Major-Project-001/VIGIL-RQ/quadruped/scripts/stl_report.txt

====================================================================================================
STL MESH ANALYSIS ù All dimensions in mm (STL native units)
====================================================================================================

--- BODY ---
File                               SizeX   SizeY   SizeZ   CenterX  CenterY  CenterZ  Long
middle.stl                          45.7    20.0    80.1       0.1    109.4     68.2     Z
                                   min=(-22.8, 99.4, 28.2)  max=(22.9, 119.4, 108.3)
side_x2.stl                         55.9   234.1     5.9       0.1    109.4     27.9     Y
                                   min=(-27.8, -7.6, 25.0)  max=(28.0, 226.5, 30.9)
horizontal_x4.stl                    7.7   134.9    80.1     -24.2     41.9     69.7     Y
                                   min=(-28.0, -25.6, 29.7)  max=(-20.3, 109.4, 109.8)
legs_middle_x2.stl                  45.8    80.3    40.0       0.1    -55.7    133.6     Y
                                   min=(-22.8, -95.9, 113.5)  max=(23.0, -15.6, 153.6)

--- HIP ---
File                               SizeX   SizeY   SizeZ   CenterX  CenterY  CenterZ  Long
hip_1.stl                           45.8    70.7    90.1       0.2    -60.0     54.4     Z
                                   min=(-22.8, -95.4, 9.3)  max=(23.1, -24.7, 99.4)
hip_2.stl                           45.8    22.0    77.2       0.2    -13.4     60.7     Z
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
                                   min=(38.1, 20.7, 34.8)  max=(62.0, 35.7, 101.8)
realsense_adapter.stl               19.2    79.5    26.0       6.2     -0.0      2.6     Y
                                   min=(-3.4, -39.8, -10.4)  max=(15.8, 39.7, 15.6)
