Major-Project-001/VIGIL-RQ/context.md

Here’s your entire content converted into a clean **Markdown (.md) file format** — structured, readable, and ready to drop into your repo or documentation.

---

```md
# 🧠 Vision Module Prompt + Project Structure (Quadruped Robotics)

---

## 🔥 ANTIGRAVITY PROMPT

You are building a modular Python-based vision system for a quadruped robotics project.

The goal is to implement the **Vision and Perception Layer** of a larger robotics pipeline, where webcam input is processed using MediaPipe to extract human pose or hand landmarks, and convert them into high-level directional commands (LEFT, RIGHT, FORWARD, STOP).

This module must be clean, modular, and extensible so it can later integrate with:
- Reinforcement Learning locomotion (PPO)
- FPGA-based motor control
- Real-time robot navigation

---

### 📌 FUNCTIONAL REQUIREMENTS

1. Capture real-time video from webcam using OpenCV  
2. Use MediaPipe for:
   - Pose detection (primary)
   - Hand detection (optional module)  
3. Extract landmark coordinates (normalized x, y)  
4. Convert landmarks into decisions:
   - Nose.x < 0.4 → MOVE LEFT  
   - Nose.x > 0.6 → MOVE RIGHT  
   - Otherwise → CENTER / FORWARD  
5. Display:
   - Annotated video feed (with landmarks)
   - Current decision text overlay  
6. Print decisions to console (for debugging)

---

### 📌 SYSTEM DESIGN REQUIREMENTS

- Follow modular architecture  
- Separate concerns:
  - Vision processing  
  - Decision logic  
  - Application entry point  
- Code must be readable, commented, and beginner-friendly  
- Avoid unnecessary complexity  

---

### 📌 FILE STRUCTURE TO IMPLEMENT

```

project_root/
│
├── main.py                  # Entry point
│
├── vision/
│   ├── **init**.py
│   ├── pose_detector.py     # MediaPipe pose logic
│   ├── hand_detector.py     # (optional) hand tracking
│
├── logic/
│   ├── **init**.py
│   ├── decision.py          # Converts coordinates → commands
│
├── utils/
│   ├── **init**.py
│   ├── display.py           # Drawing + UI overlays
│
├── config/
│   ├── settings.py          # Thresholds (0.4, 0.6 etc.)
│
└── requirements.txt

````

---

### 📌 IMPLEMENTATION DETAILS

#### `pose_detector.py`
- Initialize MediaPipe Pose  
- Process frame → return landmarks  
- Provide helper function:
```python
get_keypoint(landmarks, index)
````

#### `decision.py`

* Function:

```python
get_direction(nose_x)
```

* Returns:

```
"LEFT", "RIGHT", "CENTER"
```

#### `display.py`

* Draw landmarks
* Overlay direction text
* Show output window

#### `main.py`

* Capture webcam
* Call pose detector
* Extract nose coordinate
* Pass to decision logic
* Display results

---

### 📌 OUTPUT EXPECTATIONS

* Working real-time webcam system
* Clean console logs
* Visual feedback window
* Easily extendable for:

  * YOLO integration
  * Robot control commands

---

### 📌 CONTEXT (IMPORTANT)

This is part of a quadruped robotics system where:

* Vision runs on a laptop
* Control runs on FPGA
* Decisions from this module will later drive locomotion

Keep code lightweight and CPU-efficient.

---

## 📁 PROJECT STRUCTURE

```
quadruped_vision/
│
├── main.py
│
├── vision/
│   ├── pose_detector.py
│   ├── hand_detector.py
│
├── logic/
│   ├── decision.py
│
├── utils/
│   ├── display.py
│
├── config/
│   ├── settings.py
│
└── requirements.txt
```

---

## 🧠 WHY THIS STRUCTURE

### 🔹 vision/

Handles **perception layer**

* MediaPipe now
* YOLO later

---

### 🔹 logic/

Handles **decision making**

* Converts raw data → commands
* Later becomes:

  * RL input
  * Navigation logic

---

### 🔹 utils/

Handles **UI/debug**

* Keeps core logic clean
* Prevents messy code

---

### 🔹 config/

Critical for tuning:

```python
LEFT_THRESHOLD = 0.4
RIGHT_THRESHOLD = 0.6
```

---

### 🔹 main.py

Pipeline controller:

```
Camera → Vision → Logic → Output
```

---

## ⚠️ IMPORTANT NOTE

Avoid putting everything in one file.

If you do:

* YOLO integration becomes painful
* FPGA integration becomes messy
* Debugging becomes harder

This structure = scalable + maintainable

---

## 🚀 HOW TO RUN

```bash
python main.py
```

---

## ✅ EXPECTED RESULT

* Webcam opens
* Pose landmarks visible
* LEFT / RIGHT / CENTER printed
* Overlay visible on screen

---

## 🔜 NEXT PHASE

After this works:

* Replace MediaPipe with YOLO (or hybrid)
* Send output → FPGA (via Serial / Socket)
* Integrate with RL locomotion

---

## 🧩 SYSTEM FLOW

```
Camera → Vision → Decision → FPGA → Robot Movement
```

---

## 🧠 FINAL NOTE

This module is not just a demo.

It becomes:

* Your perception system
* Your control trigger
* Your integration bridge

Treat it like a real subsystem, not a script.

```

---

If you want, I can also:
- Generate a **downloadable `.md` file**
- Or convert this into a **GitHub-ready README with badges + diagrams**
```
