Major-Project-001/VIGIL-RQ/image.png

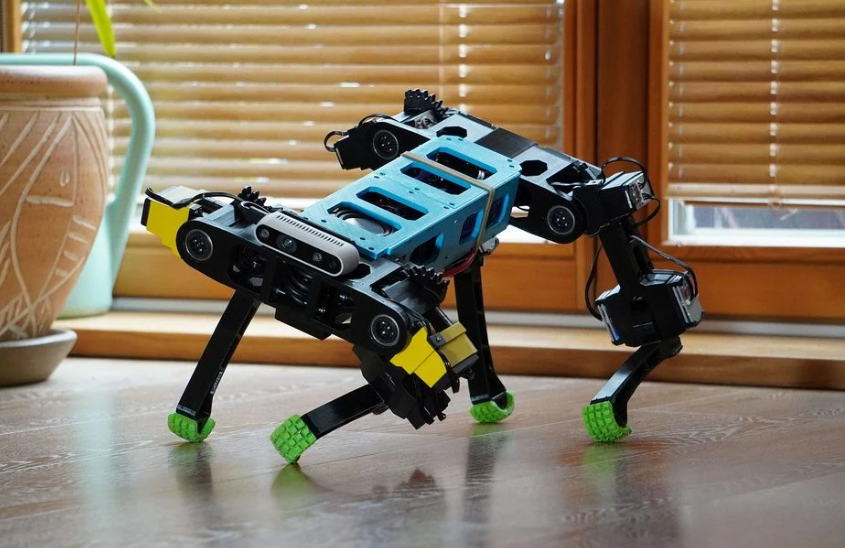
image.png
