Major-Project-001/VIGIL-RQ/quadruped/urdf/meshes/middle.stl

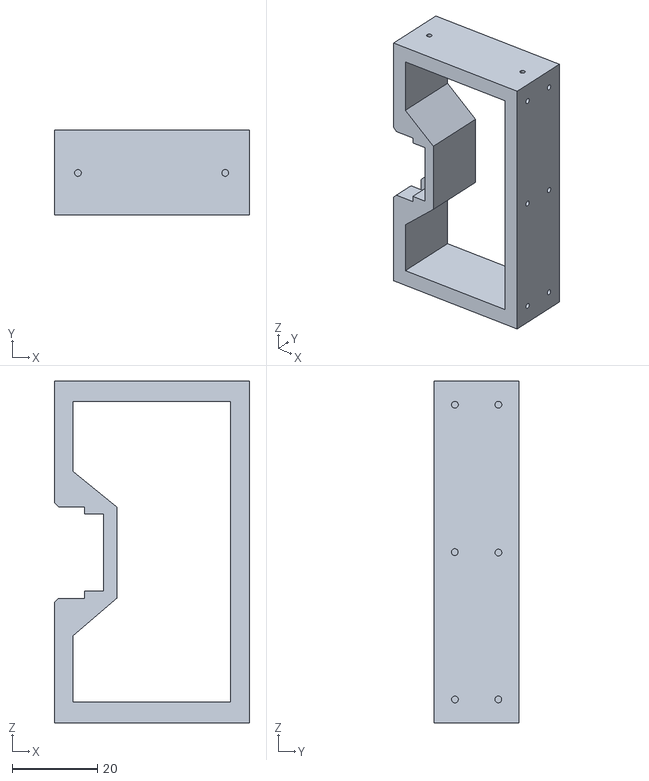
[picture p9: CAD file, 2026-04-13]
quadruped/urdf/meshes/middle.stl
45.7 x 20.0 x 80.1
