Major-Project-001/VIGIL-RQ/quadruped/urdf/meshes_centered/PI4_up.stl

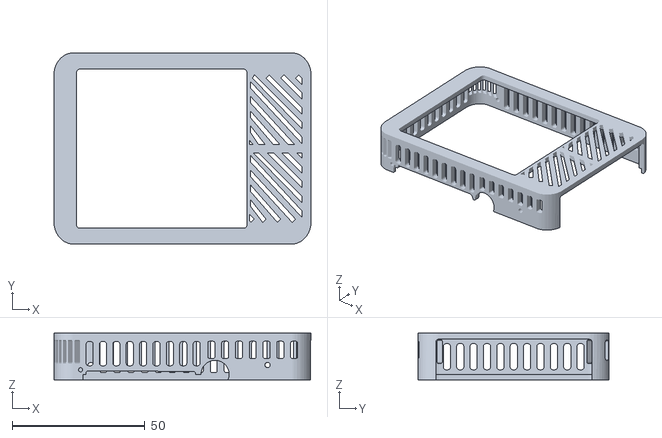
[picture p10: CAD file, 2026-04-13]
quadruped/urdf/meshes_centered/PI4_up.stl
96.9 x 72.2 x 17.7
