Major-Project-001/VIGIL-RQ/quadruped/urdf/meshes_export/29KG_Servo_DS3218MG_001.stl

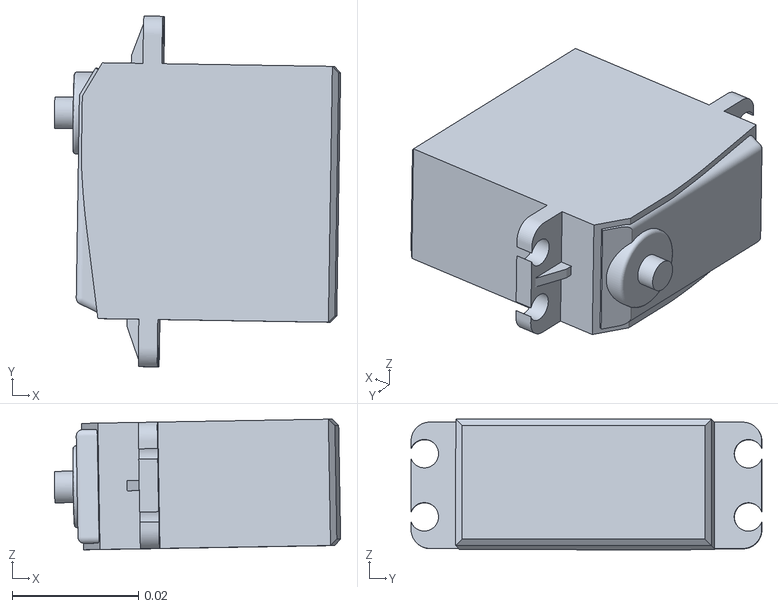
[picture p11: CAD file, 2026-04-13]
quadruped/urdf/meshes_export/29KG_Servo_DS3218MG_001.stl
0.0453 x 0.0555 x 0.0207
