Major-Project-001/VIGIL-RQ/quadruped/urdf/meshes/hip_servo_gear.stl

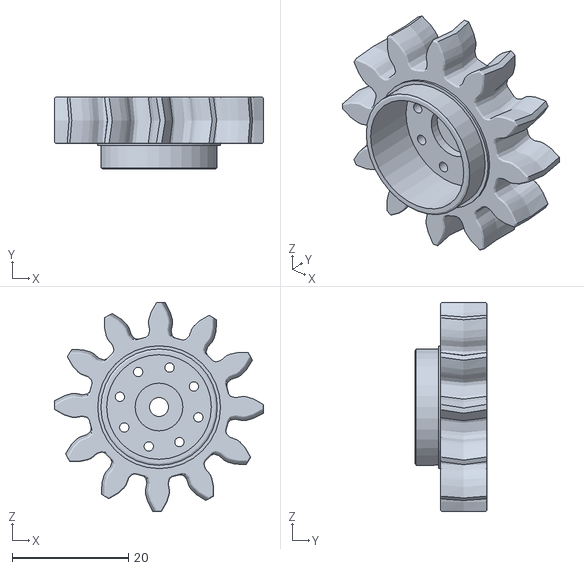
[picture p12: CAD file, 2026-04-13]
quadruped/urdf/meshes/hip_servo_gear.stl
36.0 x 12.4 x 36.0
