Major-Project-001/VIGIL-RQ/quadruped/urdf/meshes_centered/PI4_down.stl

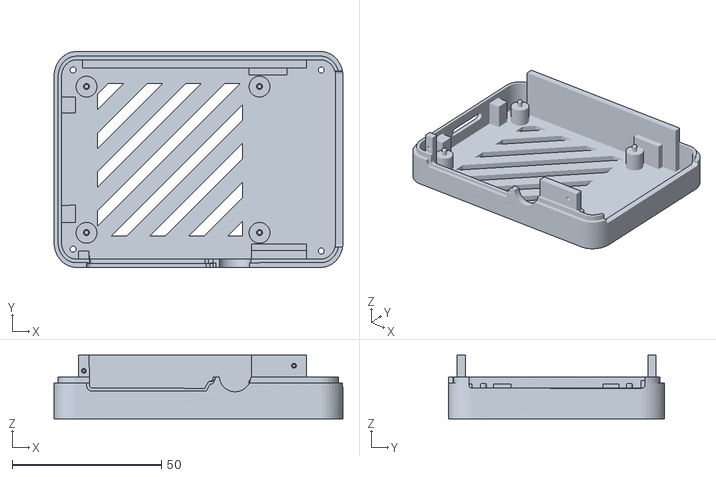
[picture p13: CAD file, 2026-04-13]
quadruped/urdf/meshes_centered/PI4_down.stl
96.9 x 72.4 x 21.4
