Major-Project-001/VIGIL-RQ/quadruped/urdf/meshes_export/RR__lower_leg_servo_horn_x2_005.stl

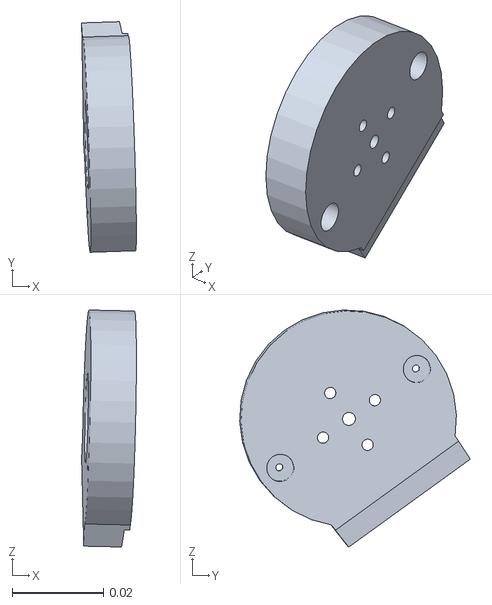
[picture p14: CAD file, 2026-04-13]
quadruped/urdf/meshes_export/RR__lower_leg_servo_horn_x2_005.stl
0.012 x 0.0505 x 0.0519
