Major-Project-001/VIGIL-RQ/quadruped/urdf/meshes/foot.stl

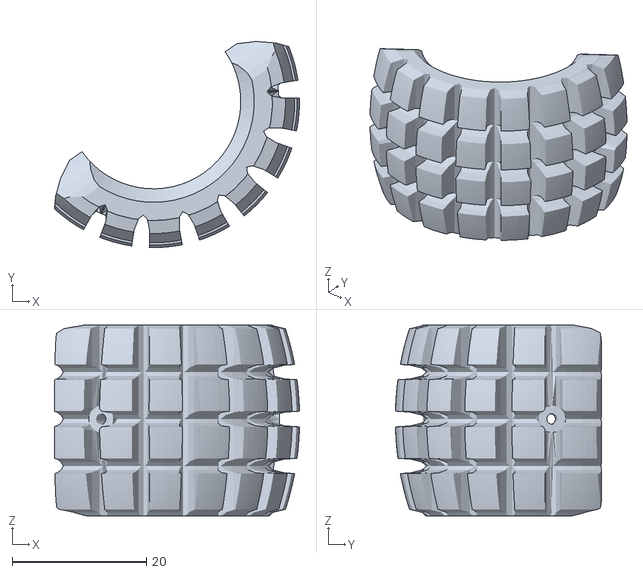
[picture p15: CAD file, 2026-04-13]
quadruped/urdf/meshes/foot.stl
36.5 x 30.7 x 28.4
