Major-Project-001/VIGIL-RQ/quadruped/urdf/meshes_export/29KG_Servo_DS3218MG.stl

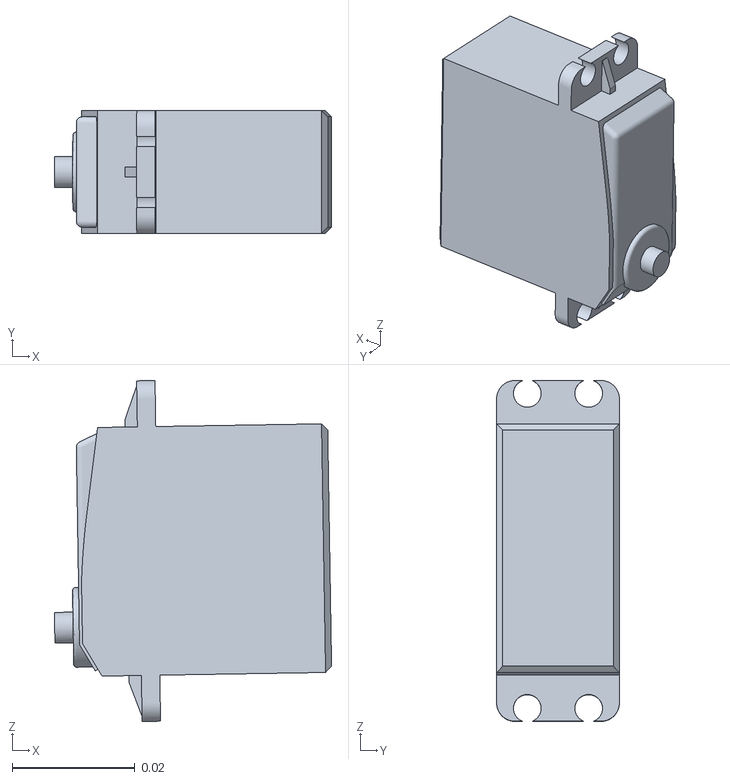
[picture p16: CAD file, 2026-04-13]
quadruped/urdf/meshes_export/29KG_Servo_DS3218MG.stl
0.0451 x 0.02 x 0.0555
