Major-Project-001/VIGIL-RQ/quadruped/urdf/meshes/lower_leg.stl

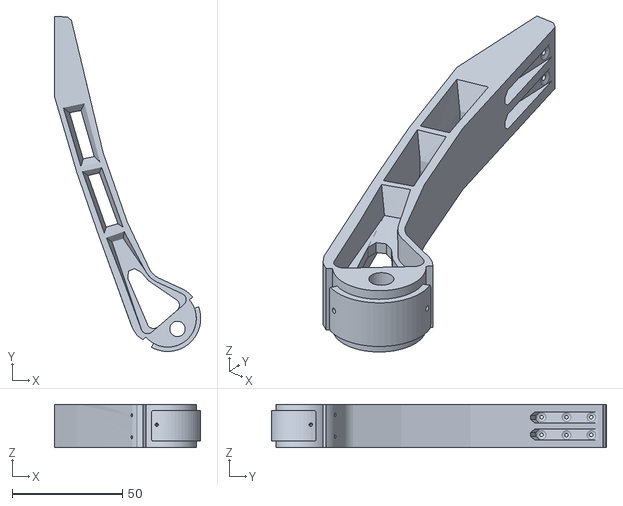
[picture p17: CAD file, 2026-04-13]
quadruped/urdf/meshes/lower_leg.stl
66.5 x 152.1 x 19.7
