Major-Project-001/VIGIL-RQ/quadruped/urdf/meshes_centered/side_x2.stl

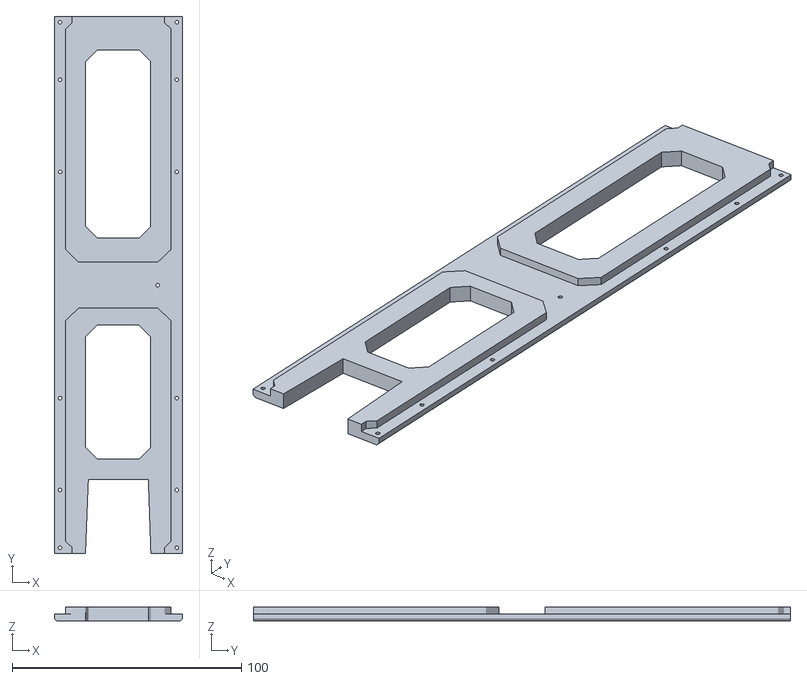
[picture p18: CAD file, 2026-04-13]
quadruped/urdf/meshes_centered/side_x2.stl
55.9 x 234.1 x 5.91
