Major-Project-001/VIGIL-RQ/quadruped/urdf/meshes_export/legs_middle_x2_001.stl

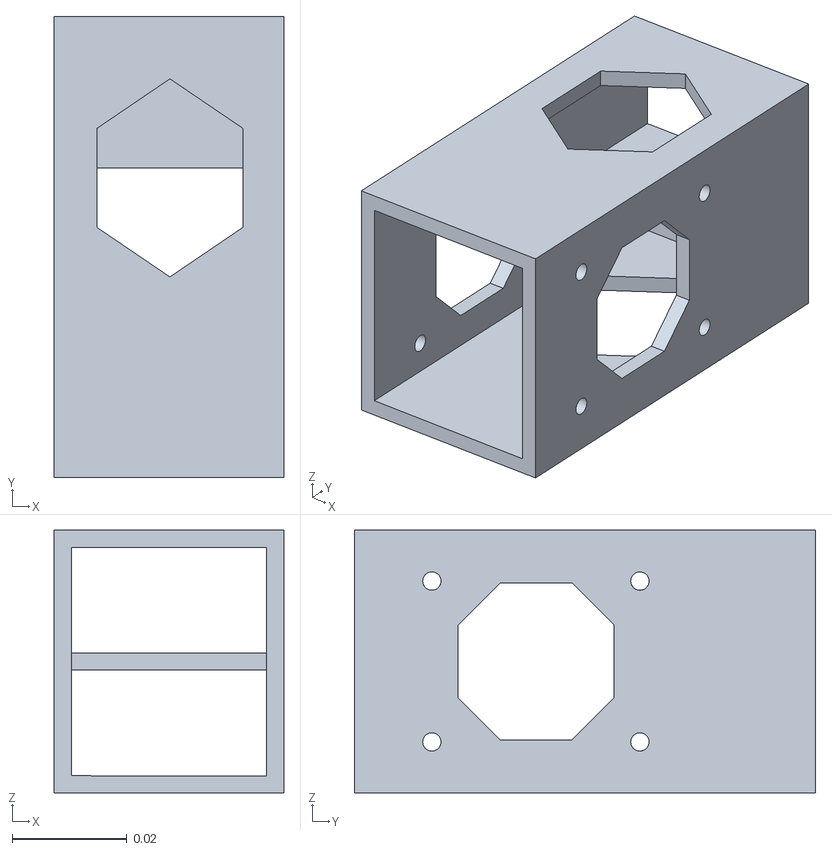
[picture p19: CAD file, 2026-04-13]
quadruped/urdf/meshes_export/legs_middle_x2_001.stl
0.04 x 0.0803 x 0.0458
