Major-Project-001/VIGIL-RQ/quadruped/urdf/meshes_centered/legs_middle_x2.stl

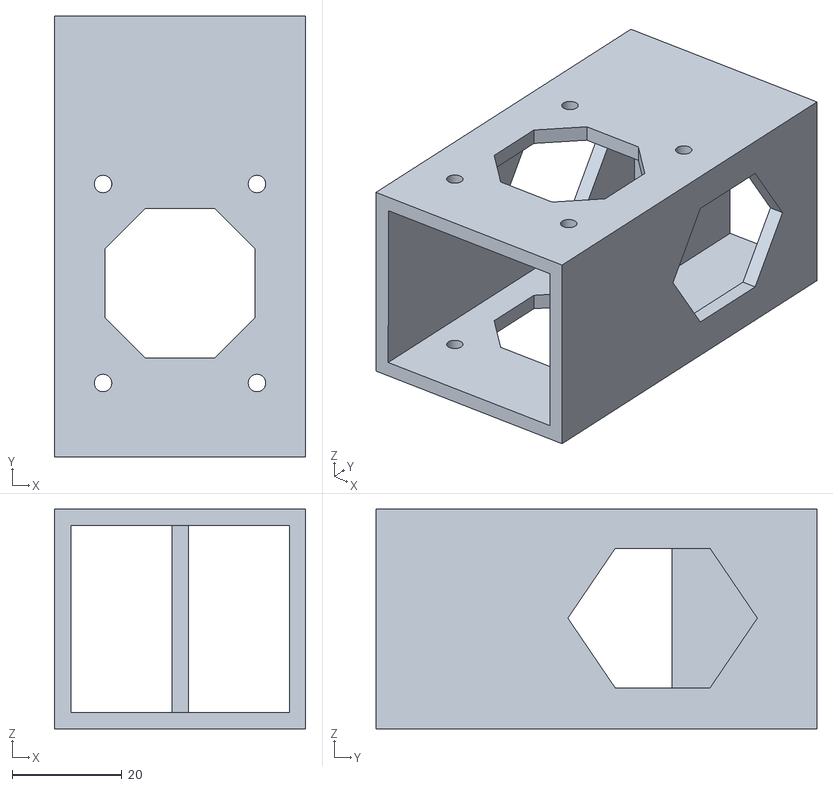
[picture p20: CAD file, 2026-04-13]
quadruped/urdf/meshes_centered/legs_middle_x2.stl
45.8 x 80.3 x 40.0
