Major-Project-001/VIGIL-RQ/quadruped/urdf/meshes_export/horizontal_x4_002.stl

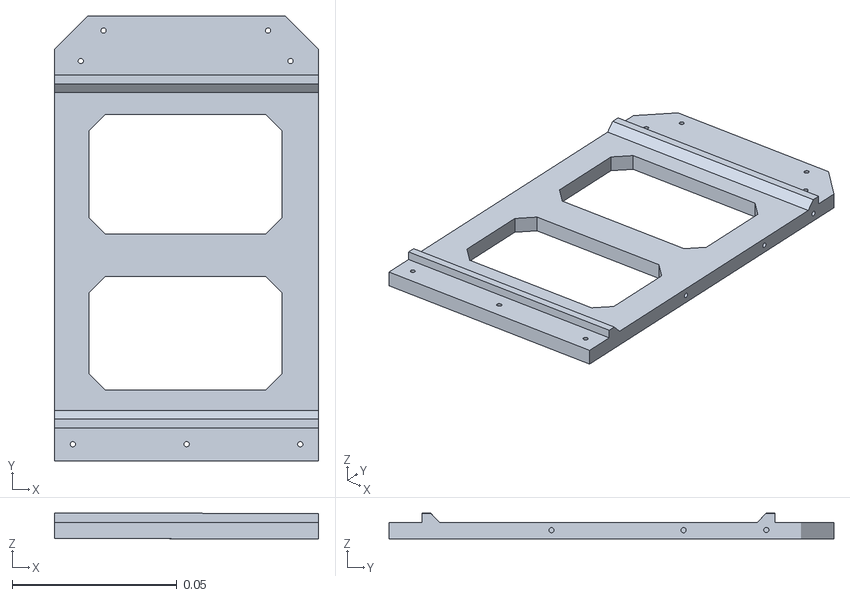
[picture p21: CAD file, 2026-04-13]
quadruped/urdf/meshes_export/horizontal_x4_002.stl
0.0801 x 0.135 x 0.00775
