Major-Project-001/VIGIL-RQ/quadruped/urdf/meshes_local/RR__lower_leg_001.stl

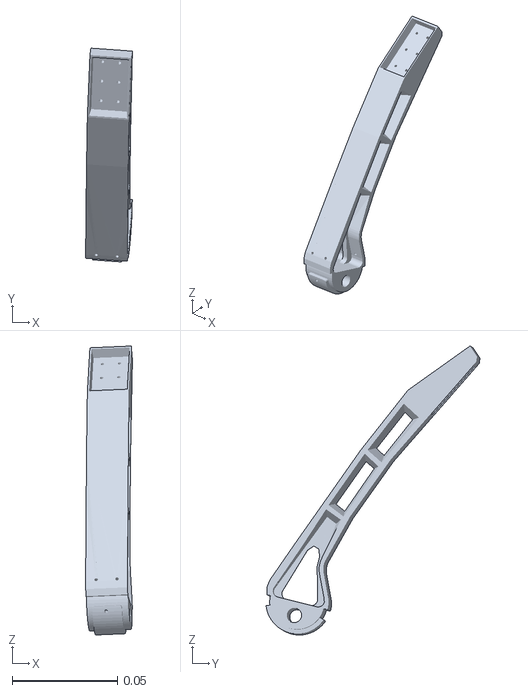
[picture p22: CAD file, 2026-04-13]
quadruped/urdf/meshes_local/RR__lower_leg_001.stl
0.0222 x 0.101 x 0.137
