Major-Project-001/VIGIL-RQ/quadruped/urdf/meshes/hip_cup.stl

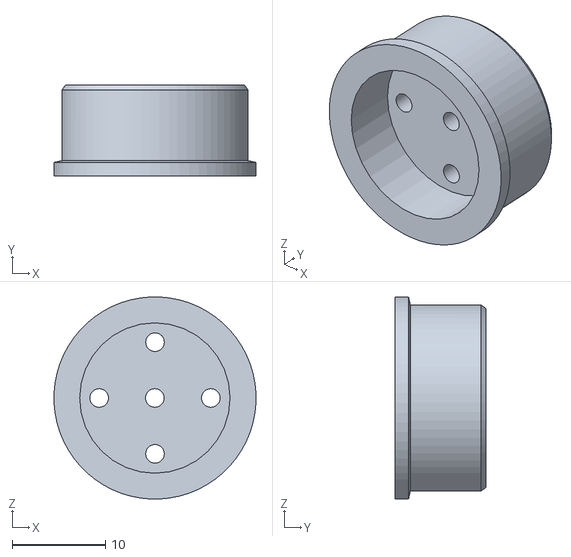
[picture p23: CAD file, 2026-04-13]
quadruped/urdf/meshes/hip_cup.stl
21.7 x 9.74 x 21.7
