Major-Project-001/VIGIL-RQ/quadruped/urdf/meshes_centered/realsense_adapter.stl

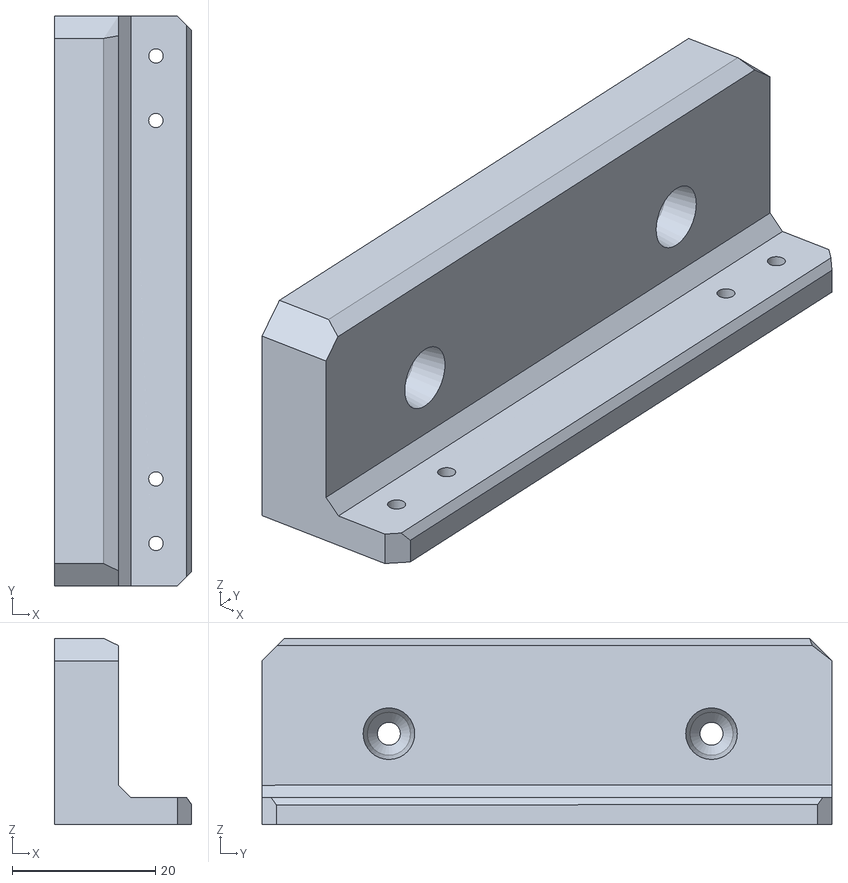
[picture p24: CAD file, 2026-04-13]
quadruped/urdf/meshes_centered/realsense_adapter.stl
19.2 x 79.5 x 26.0
