Major-Project-001/VIGIL-RQ/quadruped/urdf/meshes_local/RR__upper_leg_x2_003.stl

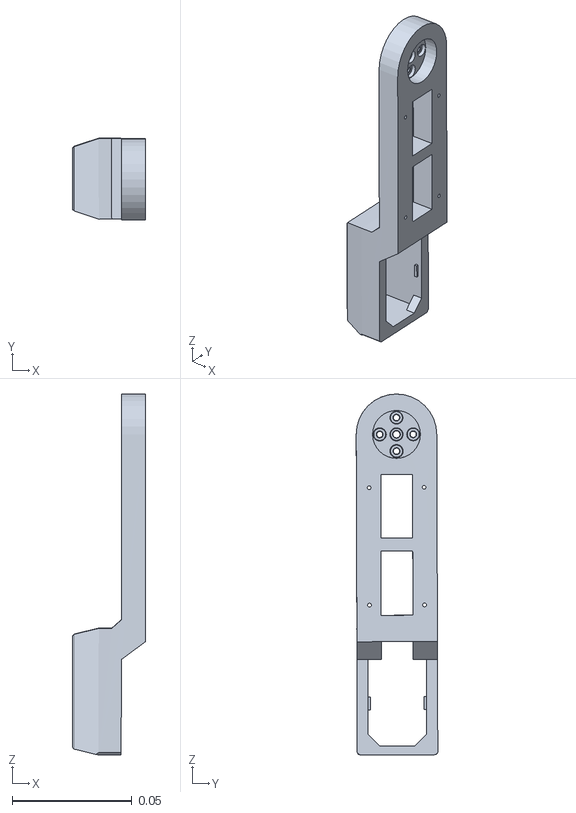
[picture p25: CAD file, 2026-04-13]
quadruped/urdf/meshes_local/RR__upper_leg_x2_003.stl
0.0306 x 0.0341 x 0.151
