Major-Project-001/VIGIL-RQ/quadruped/urdf/meshes/battery_support_2.stl

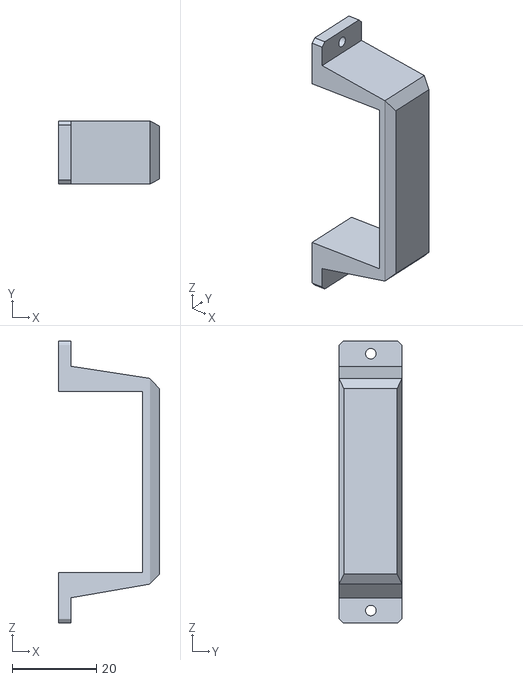
[picture p26: CAD file, 2026-04-13]
quadruped/urdf/meshes/battery_support_2.stl
24.0 x 15.0 x 67.0
