Major-Project-001/VIGIL-RQ/quadruped/urdf/meshes_centered/hip_1.stl

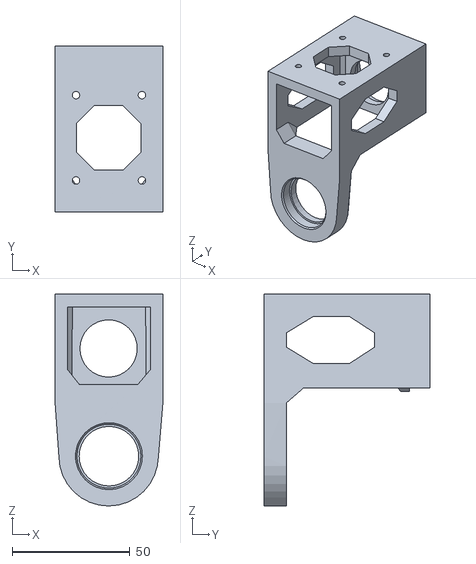
[picture p27: CAD file, 2026-04-13]
quadruped/urdf/meshes_centered/hip_1.stl
45.8 x 70.7 x 90.1
