Major-Project-001/VIGIL-RQ/quadruped/urdf/meshes/lower_leg_servo_horn_x2.stl

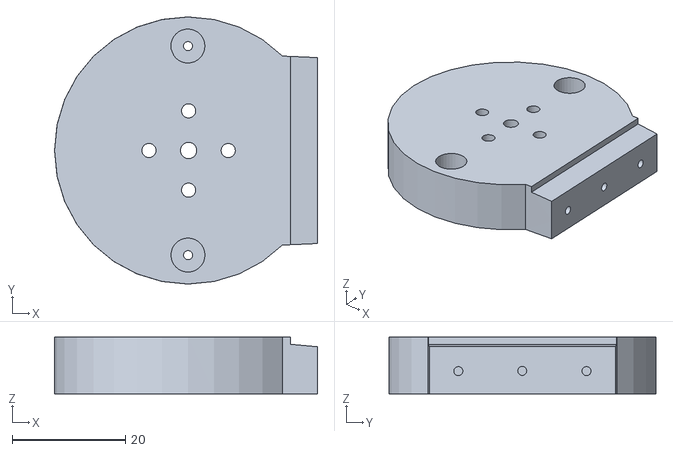
[picture p28: CAD file, 2026-04-13]
quadruped/urdf/meshes/lower_leg_servo_horn_x2.stl
46.5 x 47.2 x 9.98
