Major-Project-001/VIGIL-RQ/quadruped/urdf/meshes_centered/servo_frame_1.stl

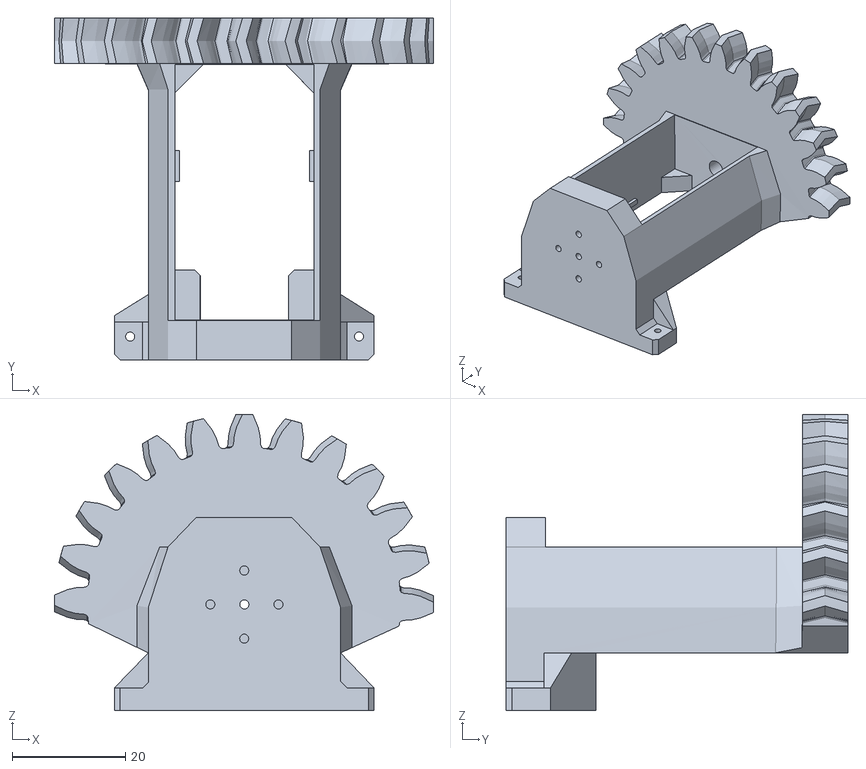
[picture p29: CAD file, 2026-04-13]
quadruped/urdf/meshes_centered/servo_frame_1.stl
66.8 x 60.2 x 52.3
