Major-Project-001/VIGIL-RQ/quadruped/urdf/meshes_local/RR__foot_002.stl

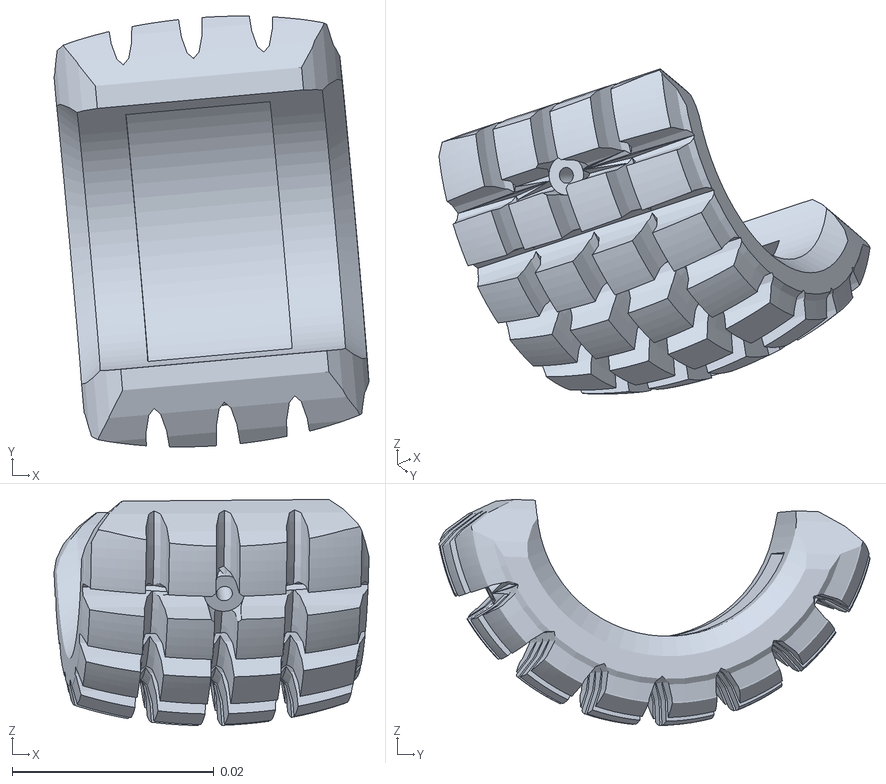
[picture p30: CAD file, 2026-04-13]
quadruped/urdf/meshes_local/RR__foot_002.stl
0.0312 x 0.0427 x 0.0224
