Major-Project-001/VIGIL-RQ/quadruped/urdf/meshes_centered/ESC_down.stl

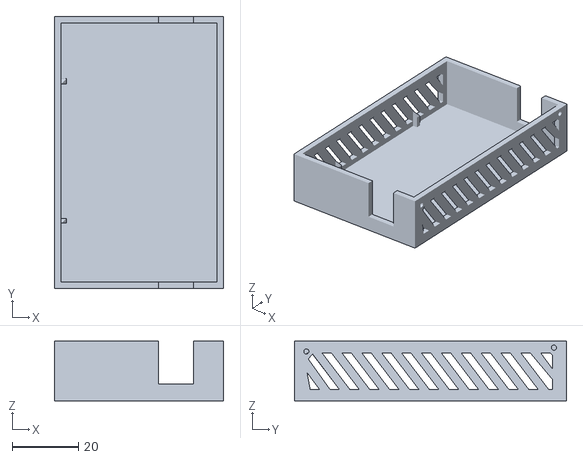
[picture p31: CAD file, 2026-04-13]
quadruped/urdf/meshes_centered/ESC_down.stl
51.1 x 82.1 x 18.0
