Major-Project-001/VIGIL-RQ/quadruped/urdf/meshes_local/RR__servo_frame_1_002.stl

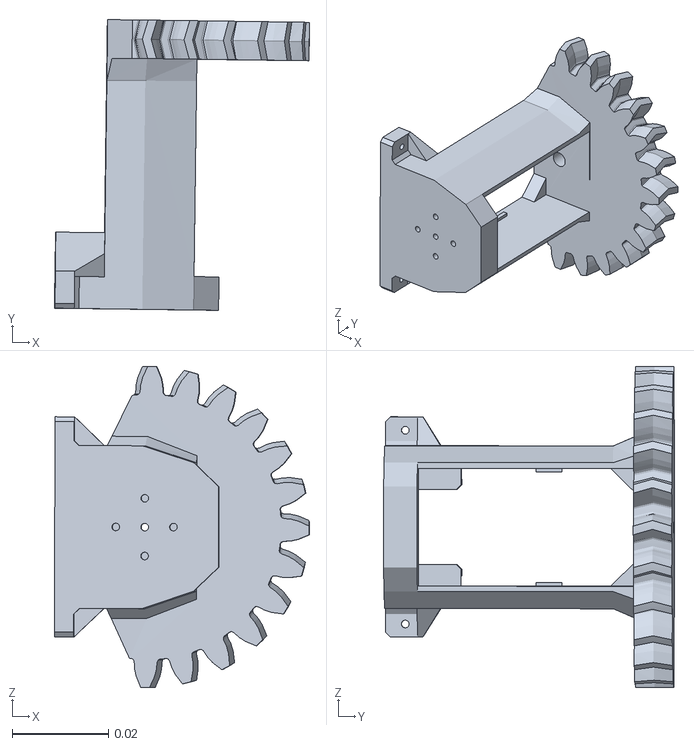
[picture p32: CAD file, 2026-04-13]
quadruped/urdf/meshes_local/RR__servo_frame_1_002.stl
0.0531 x 0.0605 x 0.0668
