Major-Project-001/VIGIL-RQ/quadruped/urdf/meshes/upper_leg_x2.stl

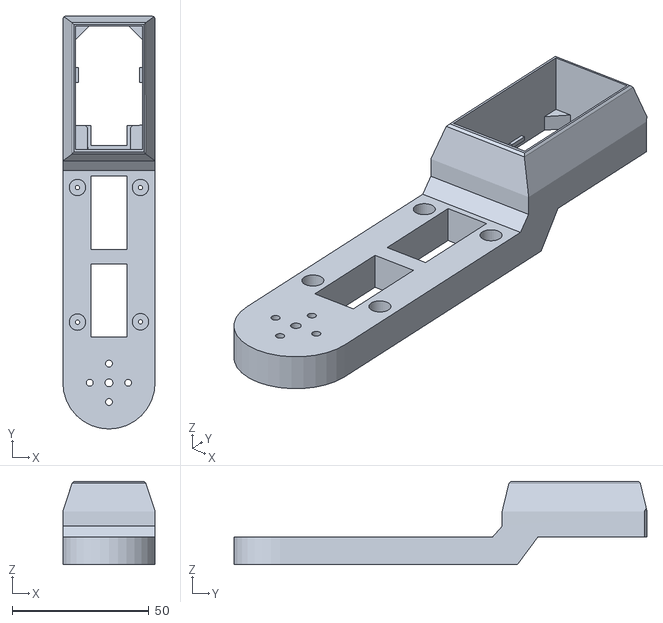
[picture p33: CAD file, 2026-04-13]
quadruped/urdf/meshes/upper_leg_x2.stl
33.7 x 150.8 x 30.4
