Major-Project-001/VIGIL-RQ/quadruped/urdf/meshes_centered/hip_2.stl

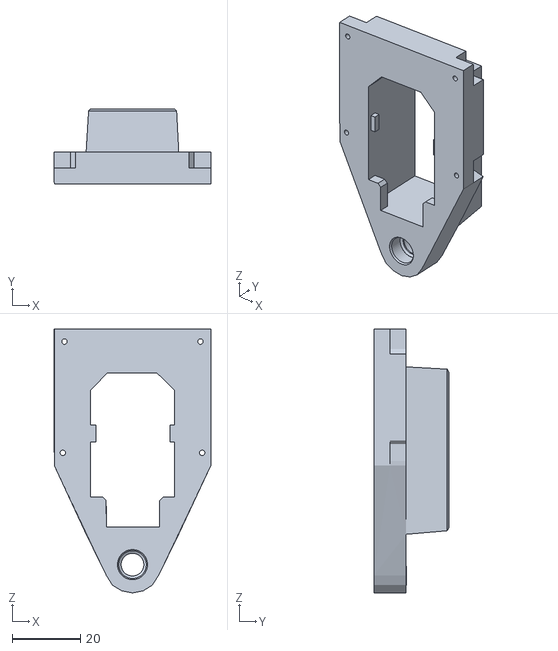
[picture p34: CAD file, 2026-04-13]
quadruped/urdf/meshes_centered/hip_2.stl
45.8 x 22.0 x 77.2
