Major-Project-001/VIGIL-RQ/quadruped/urdf/meshes_local/hip_servo_gear_001.stl

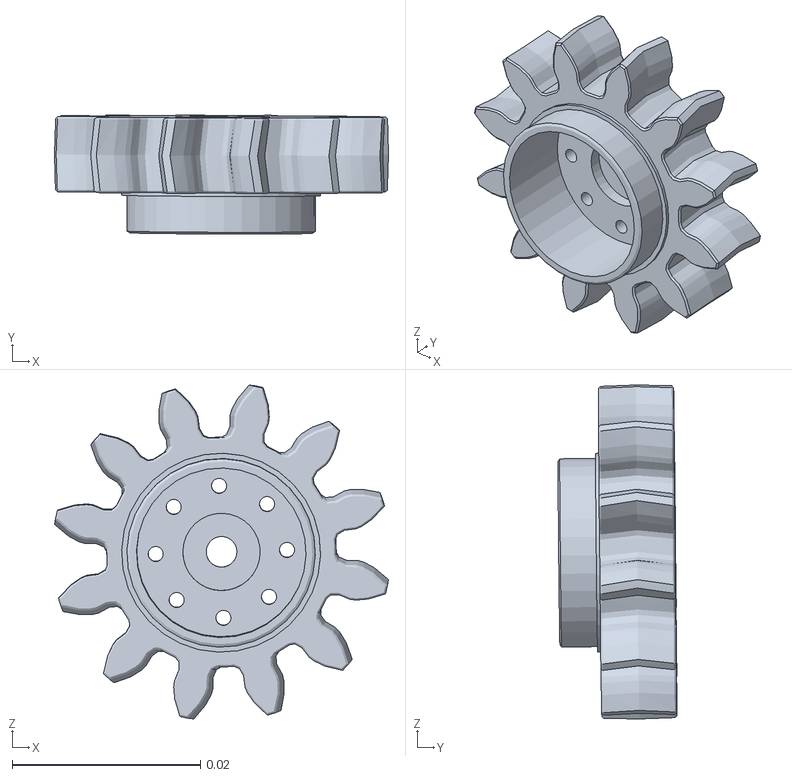
[picture p35: CAD file, 2026-04-13]
quadruped/urdf/meshes_local/hip_servo_gear_001.stl
0.0355 x 0.0127 x 0.0355
