Major-Project-001/VIGIL-RQ/quadruped/urdf/meshes_export/RR__hip_2_001.stl

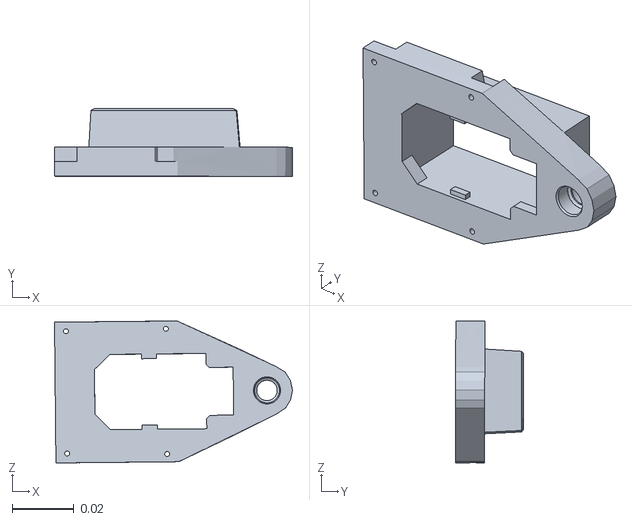
[picture p36: CAD file, 2026-04-13]
quadruped/urdf/meshes_export/RR__hip_2_001.stl
0.0774 x 0.0221 x 0.0462
