Major-Project-001/VIGIL-RQ/quadruped/urdf/meshes_local/hip_1.stl

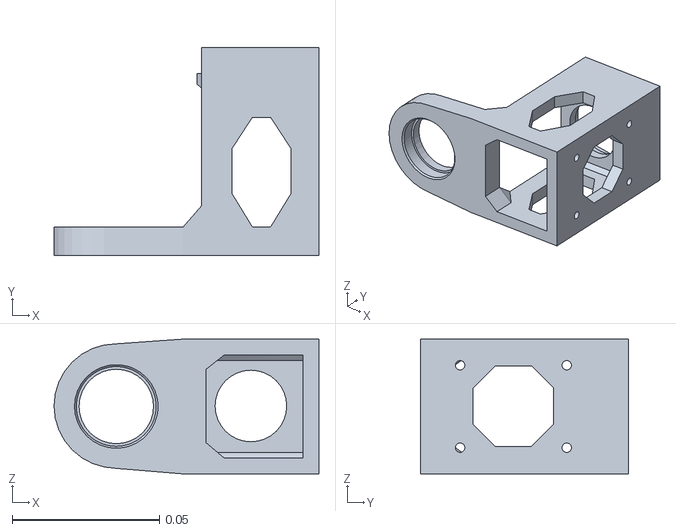
[picture p37: CAD file, 2026-04-13]
quadruped/urdf/meshes_local/hip_1.stl
0.0901 x 0.0707 x 0.0458
