Major-Project-001/VIGIL-RQ/quadruped/urdf/meshes/servo_frame_2.stl

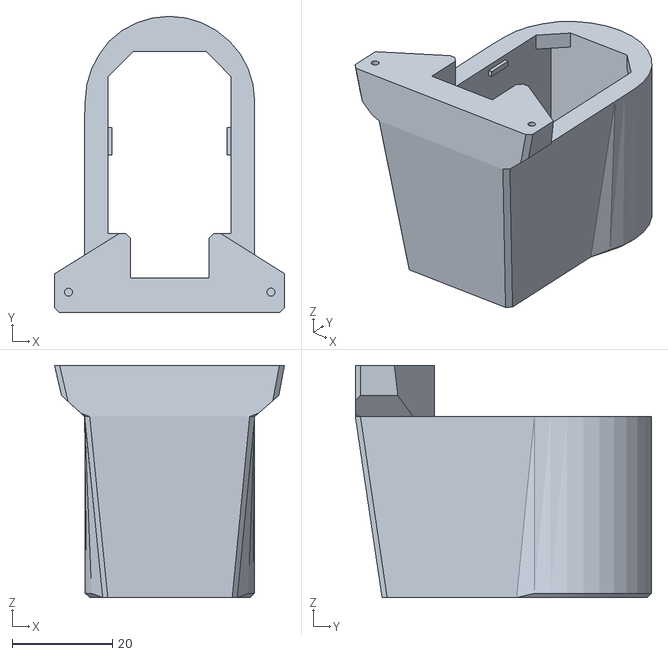
[picture p38: CAD file, 2026-04-13]
quadruped/urdf/meshes/servo_frame_2.stl
45.8 x 59.0 x 46.3
