Major-Project-001/VIGIL-RQ/quadruped/urdf/meshes_centered/horizontal_x4.stl

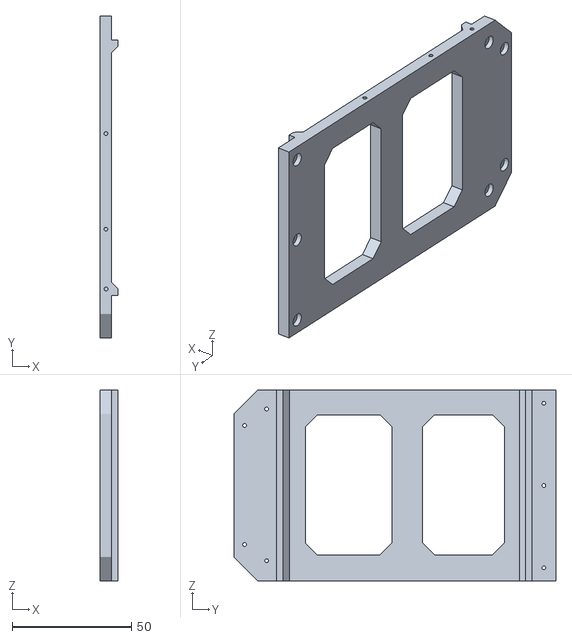
[picture p39: CAD file, 2026-04-13]
quadruped/urdf/meshes_centered/horizontal_x4.stl
7.74 x 134.9 x 80.1
