Major-Project-001/VIGIL-RQ/quadruped/urdf/meshes/ESC_up.stl

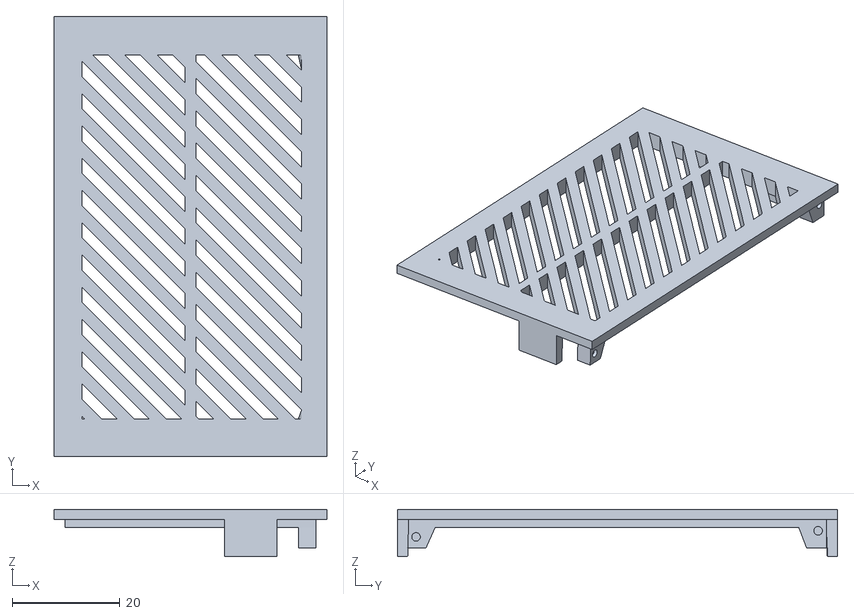
[picture p40: CAD file, 2026-04-13]
quadruped/urdf/meshes/ESC_up.stl
50.8 x 81.8 x 8.83
