Major-Project-001/VIGIL-RQ/quadruped/urdf/meshes/battery_support_1.stl

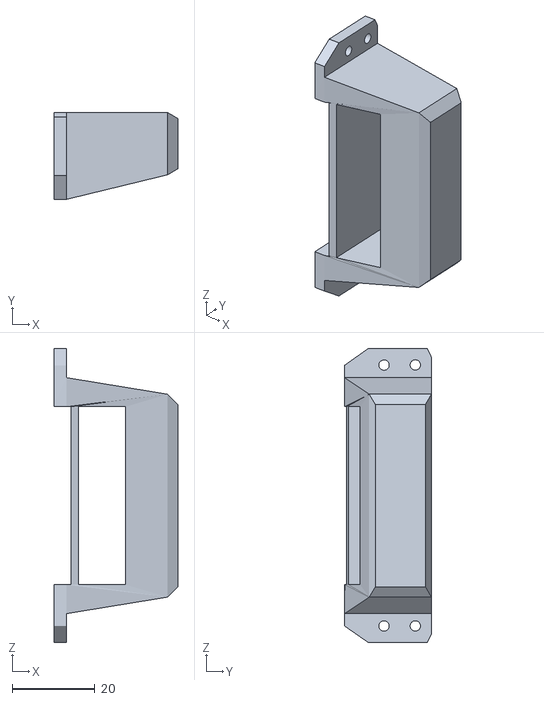
[picture p41: CAD file, 2026-04-13]
quadruped/urdf/meshes/battery_support_1.stl
29.9 x 20.9 x 71.0
