Major-Project-001/VIGIL-RQ/quadruped/urdf/meshes_local/hip_cup.stl

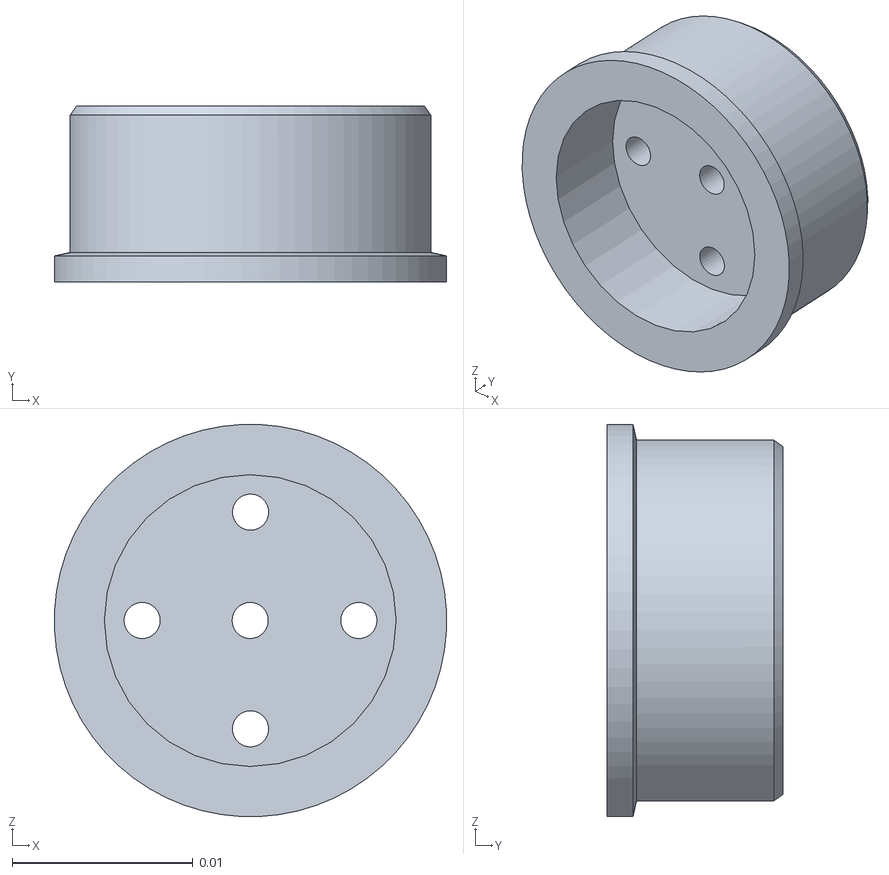
[picture p42: CAD file, 2026-04-13]
quadruped/urdf/meshes_local/hip_cup.stl
0.0217 x 0.00974 x 0.0217
