Major-Project-001/VIGIL-RQ/quadruped/urdf/meshes_export/side_x2_001.stl

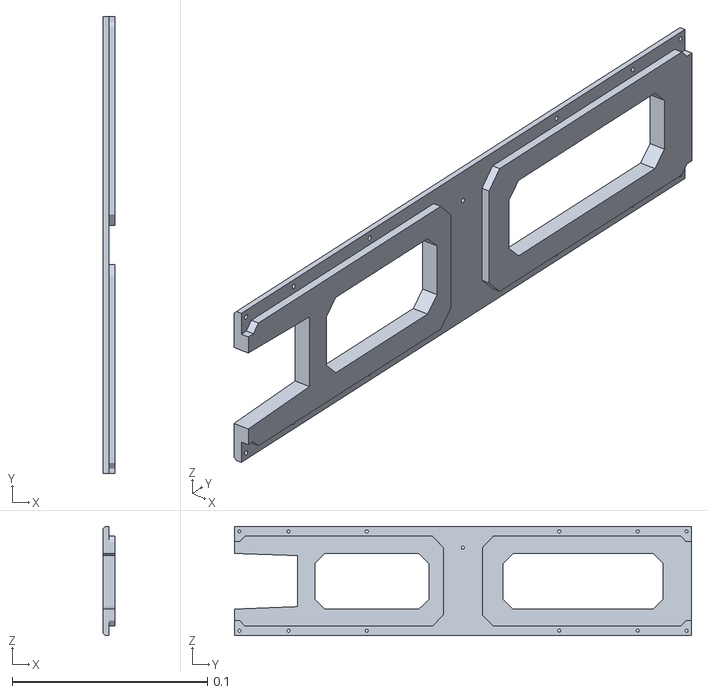
[picture p43: CAD file, 2026-04-13]
quadruped/urdf/meshes_export/side_x2_001.stl
0.00591 x 0.234 x 0.0559
