Major-Project-001/VIGIL-RQ/(list of files, cad)

Other CAD files:
quadruped/urdf/meshes_local/29KG_Servo_DS3218MG_002.stl
quadruped/urdf/meshes_local/RR__lower_leg_servo_horn_x2_005.stl
quadruped/urdf/meshes_centered/foot.stl
quadruped/urdf/meshes_local/29KG_Servo_DS3218MG_009.stl
quadruped/urdf/meshes_local/29KG_Servo_DS3218MG_005.stl
quadruped/urdf/meshes/PI4_up.stl
quadruped/urdf/meshes_export/29KG_Servo_DS3218MG_009.stl
quadruped/urdf/meshes_export/RR__lower_leg.stl
quadruped/urdf/meshes_local/RR__lower_leg_servo_horn_x2.stl
quadruped/urdf/meshes_export/29KG_Servo_DS3218MG_004.stl
quadruped/urdf/meshes/legs_middle_x2.stl
quadruped/urdf/meshes_export/RR__lower_leg_001.stl
quadruped/urdf/meshes_export/29KG_Servo_DS3218MG_003.stl
quadruped/urdf/meshes/servo_frame_1.stl
quadruped/urdf/meshes_centered/battery_support_2.stl
quadruped/urdf/meshes_local/RR__upper_leg_x2_001.stl
quadruped/urdf/meshes/hip_2.stl
quadruped/urdf/meshes_centered/upper_leg_x2.stl
quadruped/urdf/meshes_export/RR__servo_frame_1_001.stl
quadruped/urdf/meshes/hip_1.stl
quadruped/urdf/meshes_centered/lower_leg_servo_horn_x2.stl
quadruped/urdf/meshes_export/RR__servo_frame_1_002.stl
quadruped/urdf/meshes_local/RR__lower_leg_servo_horn_x2_004.stl
quadruped/urdf/meshes_export/RR__servo_frame_1.stl
quadruped/urdf/meshes_local/hip_1_002.stl
quadruped/urdf/meshes_centered/ESC_up.stl
quadruped/urdf/meshes_export/RR__servo_frame_1_003.stl
quadruped/urdf/meshes_local/horizontal_x4_001.stl
quadruped/urdf/meshes_centered/hip_cup.stl
quadruped/urdf/meshes_export/hip_1_001.stl
quadruped/urdf/meshes_local/RR__lower_leg_servo_horn_x2_006.stl
quadruped/urdf/meshes/PI4_down.stl
quadruped/urdf/meshes_centered/middle.stl
quadruped/urdf/meshes_export/29KG_Servo_DS3218MG_005.stl
quadruped/urdf/meshes/horizontal_x4.stl
quadruped/urdf/meshes_centered/battery_support_1.stl
quadruped/urdf/meshes_export/RR__foot_002.stl
quadruped/urdf/meshes_local/hip_1_003.stl
quadruped/urdf/meshes/ESC_down.stl
quadruped/urdf/meshes_centered/servo_frame_2.stl
quadruped/urdf/meshes_export/RR__hip_2.stl
quadruped/urdf/meshes_local/hip_cup_001.stl
quadruped/urdf/meshes/realsense_adapter.stl
quadruped/urdf/meshes_centered/hip_servo_gear.stl
quadruped/urdf/meshes_export/RR__upper_leg_x2_002.stl
quadruped/urdf/meshes_local/RR__lower_leg_servo_horn_x2_007.stl
quadruped/urdf/meshes/side_x2.stl
quadruped/urdf/meshes_centered/lower_leg.stl
quadruped/urdf/meshes_export/RR__upper_leg_x2.stl
quadruped/urdf/meshes_local/hip_servo_gear_002.stl
quadruped/urdf/meshes_export/RR__upper_leg_x2_001.stl
quadruped/urdf/meshes_local/horizontal_x4_002.stl
quadruped/urdf/meshes_export/horizontal_x4_003.stl
quadruped/urdf/meshes_local/29KG_Servo_DS3218MG_003.stl
quadruped/urdf/meshes_export/29KG_Servo_DS3218MG_002.stl
quadruped/urdf/meshes_local/RR__hip_2.stl
quadruped/urdf/meshes_export/RR__lower_leg_servo_horn_x2_006.stl
quadruped/urdf/meshes_local/hip_servo_gear_003.stl
quadruped/urdf/meshes_export/RR__upper_leg_x2_003.stl
quadruped/urdf/meshes_local/RR__lower_leg.stl
quadruped/urdf/meshes_export/RR__foot.stl
quadruped/urdf/meshes_local/legs_middle_x2.stl
quadruped/urdf/meshes_export/29KG_Servo_DS3218MG_011.stl
quadruped/urdf/meshes_local/29KG_Servo_DS3218MG_011.stl
quadruped/urdf/meshes_export/29KG_Servo_DS3218MG_006.stl
quadruped/urdf/meshes_local/29KG_Servo_DS3218MG_006.stl
quadruped/urdf/meshes_export/hip_servo_gear_002.stl
quadruped/urdf/meshes_local/29KG_Servo_DS3218MG_001.stl
quadruped/urdf/meshes_export/RR__lower_leg_servo_horn_x2_004.stl
quadruped/urdf/meshes_local/RR__upper_leg_x2.stl
quadruped/urdf/meshes_export/RR__foot_003.stl
quadruped/urdf/meshes_local/hip_servo_gear.stl
quadruped/urdf/meshes_local/horizontal_x4.stl
quadruped/urdf/meshes_export/hip_1_003.stl
quadruped/urdf/meshes_local/hip_1_001.stl
quadruped/urdf/meshes_export/RR__foot_001.stl
quadruped/urdf/meshes_local/RR__lower_leg_003.stl
quadruped/urdf/meshes_export/hip_servo_gear_001.stl
quadruped/urdf/meshes_local/RR__hip_2_002.stl
quadruped/urdf/meshes_export/RR__lower_leg_servo_horn_x2_007.stl
quadruped/urdf/meshes_local/29KG_Servo_DS3218MG_004.stl
quadruped/urdf/meshes_export/29KG_Servo_DS3218MG_010.stl
quadruped/urdf/meshes_local/29KG_Servo_DS3218MG_007.stl
quadruped/urdf/meshes_export/RR__lower_leg_003.stl
quadruped/urdf/meshes_local/RR__lower_leg_servo_horn_x2_003.stl
quadruped/urdf/meshes_export/hip_1_002.stl
quadruped/urdf/meshes_local/RR__servo_frame_1_003.stl
quadruped/urdf/meshes_export/29KG_Servo_DS3218MG_007.stl
quadruped/urdf/meshes_local/RR__servo_frame_1.stl
quadruped/urdf/meshes_export/RR__lower_leg_servo_horn_x2_001.stl
quadruped/urdf/meshes_local/RR__lower_leg_002.stl
quadruped/urdf/meshes_export/RR__lower_leg_servo_horn_x2_002.stl
quadruped/urdf/meshes_local/side_x2.stl
quadruped/urdf/meshes_export/horizontal_x4_001.stl
quadruped/urdf/meshes_local/29KG_Servo_DS3218MG_008.stl
quadruped/urdf/meshes_export/hip_cup_001.stl
quadruped/urdf/meshes_local/RR__foot_003.stl
quadruped/urdf/meshes_export/RR__hip_2_003.stl
quadruped/urdf/meshes_local/horizontal_x4_003.stl
quadruped/urdf/meshes_export/RR__lower_leg_002.stl
quadruped/urdf/meshes_local/29KG_Servo_DS3218MG_010.stl
quadruped/urdf/meshes_export/RR__hip_2_002.stl
quadruped/urdf/meshes_local/RR__lower_leg_servo_horn_x2_001.stl
quadruped/urdf/meshes_export/29KG_Servo_DS3218MG_008.stl
quadruped/urdf/meshes_local/RR__hip_2_001.stl
quadruped/urdf/meshes_export/RR__lower_leg_servo_horn_x2.stl
quadruped/urdf/meshes_local/RR__lower_leg_servo_horn_x2_002.stl
quadruped/urdf/meshes_export/RR__lower_leg_servo_horn_x2_003.stl
quadruped/urdf/meshes_local/RR__servo_frame_1_001.stl
quadruped/urdf/meshes_export/hip_servo_gear_003.stl
quadruped/urdf/meshes_local/RR__foot.stl
quadruped/urdf/meshes_local/legs_middle_x2_001.stl
quadruped/urdf/meshes_local/RR__foot_001.stl
quadruped/urdf/meshes_local/side_x2_001.stl
quadruped/urdf/meshes_local/29KG_Servo_DS3218MG.stl
quadruped/urdf/meshes_export/hip_1.stl
quadruped/urdf/meshes_export/hip_cup.stl
quadruped/urdf/meshes_export/hip_servo_gear.stl
quadruped/urdf/meshes_export/horizontal_x4.stl
quadruped/urdf/meshes_export/legs_middle_x2.stl
quadruped/urdf/meshes_export/side_x2.stl
quadruped/urdf/meshes_local/RR__hip_2_003.stl
quadruped/urdf/meshes_local/RR__upper_leg_x2_002.stl
