Major-Project-001/VIGIL-RQ/control/calibration/index.html

🎯

# Servo Calibrator

VIGIL-RQ

Disconnected

Select Servo

◀ ▶

0.0° 1500 µs

-90° +90°

-90° -45° 0° +45° +90°

Channel 0

Joint FL Hip

Angle 0.0°

Pulse 1500 µs

Offset ±0 µs

Status Ready

⊙ Center This ⊙ Center All

💾 Save Offsets

VIGIL-RQ Quadruped · Servo Calibration Tool

Move slider to find mechanical center → lock servo horn → next servo
