Major-Project-001/VIGIL-RQ/(commit log)

2026-04-13 feat: add robust URDF generation, motor control API, and walk demo
    [29KG_Servo_DS3218MG.stl, 29KG_Servo_DS3218MG_001.stl, 29KG_Servo_DS3218MG_002.stl, 29KG_Servo_DS3218MG_003.stl, 29KG_Servo_DS3218MG_004.stl, 29KG_Servo_DS3218MG_005.stl, 29KG_Servo_DS3218MG_006.stl, 29KG_Servo_DS3218MG_007.stl]
2026-04-13 docs: Update README for urdf branch focusing on simulation and motor API
2026-04-14 Phase 1: FPGA 12-channel PWM controller (SystemVerilog, Gowin EDA) - pwm_channel.sv: Single-channel 50Hz PWM generator (27MHz clock) - spi_slave.sv: SPI Mode 0 slave receiver with clock domain crossi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
2026-04-14 Phase 2-4: RPi server, mobile web app, and wiring docs
2026-04-14 docs: Detailed pin-level wiring diagrams with color-coded Mermaid modules
2026-04-14 docs: Final wiring diagram — full detail + color-coded linkStyle on every line
2026-04-14 docs: Split PWM into 5.1-5.4 subsections, servo power into 7.1-7.4 vertical per-leg diagrams
2026-04-14 docs: Split wiring into separate files - fixes Mermaid render limits, adds more detail per section
2026-04-14 docs: Add control README with reading order, enhance all wiring docs with specs/troubleshooting/diagrams
2026-04-14 docs: Replace ASCII art with Mermaid (IMU axes, servo pinout), improve SPI timing waveform accuracy
2026-04-14 docs: Replace ASCII SPI timing with matplotlib-generated waveform diagram
2026-04-15 feat: Add servo calibration tool — webapp UI, server, RPi/FPGA/calibration setup guides
2026-04-16 fix: Clean shutdown on Ctrl+C — no more hanging terminal
    [calib_server.py]
2026-04-16 fix: Bank 3 pins (LEDs, reset) use LVCMOS18 — Tang Nano 9K 1.8V bank
2026-04-16 docs: Add SPI/PWM simulation analysis with GTKWave waveform screenshots
2026-04-16 docs: Complete wiring diagram — add battery, XL4015, LM2596, USB-C power, GND bus
2026-04-16 docs: Revert wiring diagram to LR layout with original pin labels + power blocks
2026-04-18 fix: correct servo angle range to ±90° and add FPGA watchdog keepalive
    - DS3218 servos map 500-2500µs to ±90° (180°), not ±135° (270°)
    - Updated config.py angle constants and knee joint limit
    - Updated calibration UI slider range and tick labels
    - Added 200ms keepalive to prevent FPGA watchdog snap-back during calibration
    - Fixed setup_guide.md physical limit reference
    [config.py]
2026-04-18 fix: clamp POSE_REST knee to -1.5 rad (within ±90° servo range)
    [config.py]
2026-04-18 docs: add USB-C power cable build instructions to wiring_power.md
2026-04-18 docs: update wiring_power.md with 2x 6-pin terminal blocks, 3-pack parallel battery, Mermaid diagrams
2026-04-18 docs: remove external BMS — Dragon packs have internal BMS, simplify power path
2026-04-18 docs: add 1N5822 diode on LM2596 input for reverse polarity protection
2026-04-18 docs: standardize IMU references to MPU9250 across all files
2026-04-18 fix: add missing GND connections for level shifters in PWM wiring diagram
2026-04-19 docs: update PWM wiring for 8-ch + 4-ch level shifters, knees grouped on 4-ch
2026-04-19 docs: update all files for 8-ch + 4-ch level shifters, remove stale BMS/LS3 refs
2026-04-19 docs: update 8-ch level shifter labels to A0-A7/B0-B7/VA/VB matching actual board markings
2026-04-27 feat: Add IK solver, trot/creep gaits, and PyBullet simulation
    - IK solver: Analytical 3-DOF using actual URDF dimensions (68.9/114.4/139.8mm)
    - Trot gait: IK-based diagonal trot with Bezier swing trajectories
    - Creep gait: Wave gait (1 leg at a time) for static stability
    - PyBullet sim: Interactive simulation with GUI sliders for walk testing
    [sim_walk.py]
2026-04-28 fix: Add 100us inter-frame delay to SPI driver to prevent servo jitter
    [spi_driver.py]
2026-04-28 fix: Make IMU and power monitor fault-tolerant for missing I2C sensors
    Server no longer crashes if IMU/INA219 aren't connected. Gracefully
    falls back to simulation mode with zero/dummy values.
    [imu_reader.py, power_monitor.py]
2026-04-28 fix: Watchdog message fires once instead of spamming 50Hz
    [server.py]
2026-04-28 fix: Invert RGB LED duty cycle for common-anode LED module
    [alert_manager.py]
2026-04-28 feat: Joystick auto-walk — push stick to walk, release to stop
    - Left stick controls speed + direction (auto-enters walk mode)
    - Right stick X controls yaw/turning
    - Release joystick → auto-returns to stand
    - Deadzone of 0.1 to prevent drift
    [gait_engine.py, server.py, websocket_handler.py]
2026-04-28 fix: Invert right-side servo directions for mirror-mounted thigh/knee
    FR and RR thigh/knee servos are physically mirrored, so their angles
    need to be negated. Added SERVO_DIRECTION config map applied during
    angle-to-pulse conversion.
    [config.py, spi_driver.py]
2026-04-28 tune: Sit pose — only knees fold, hip/thigh stay at neutral
2026-04-28 safety: Hard-lock hip servos at neutral in SPI driver — cannot move
2026-04-28 fix: One-shot power alert + ignore 0V sensor readings
    INA219 reads 0V when not wired in circuit, which falsely triggers
    critical battery. Now requires voltage > 1V and only prints once.
    [server.py]
